RalphWystup/Kennlinienschreiber-fuer-Transistoren-mit-ESP32-und-BJT-Modell/bilder/bjt_dashboard.png

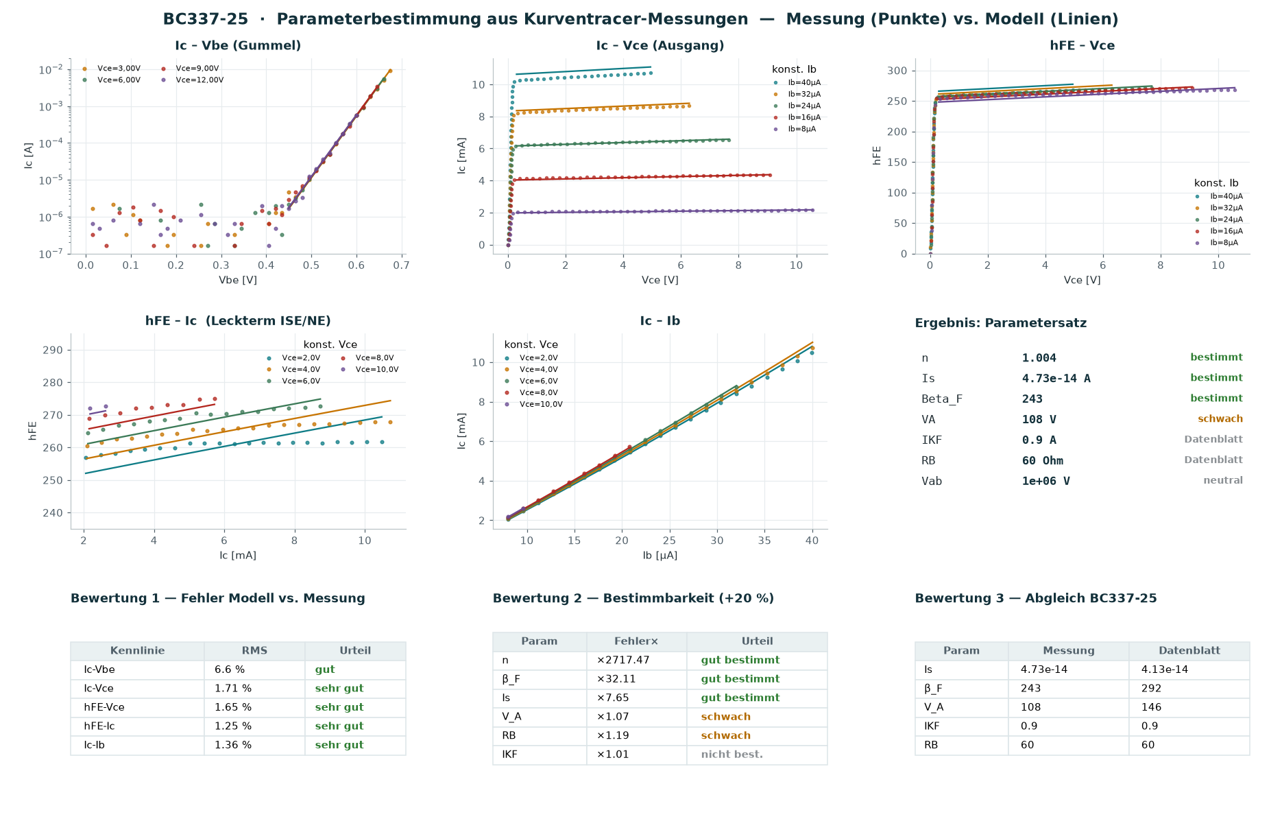
bilder/bjt_dashboard.png
