RalphWystup/Kennlinienschreiber-fuer-Transistoren-mit-ESP32-und-BJT-Modell/bilder/trendows_q3_blatt.png

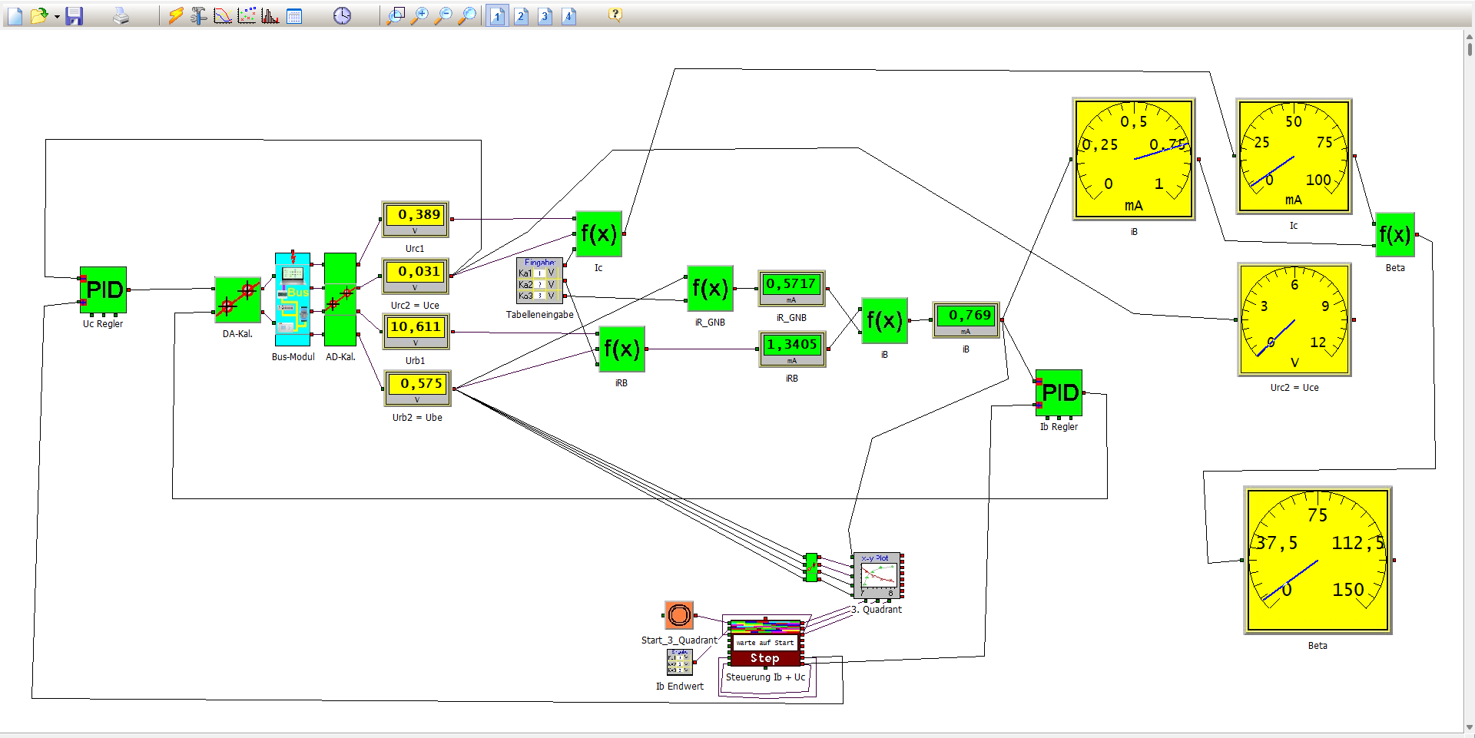
bilder/trendows_q3_blatt.png
