RalphWystup/Kennlinienschreiber-fuer-Transistoren-mit-ESP32-und-BJT-Modell/firmware/ad_da.h

// ---------------- ad_da ----------------------------------------

#ifndef __AD_DA_H__
#define __AD_DA_H__
#include "config.h"

extern "C"{

void setup_ad_da();
void WorkAdDa();

} // extern "C"
#endif /* ifndef */
