RalphWystup/Kennlinienschreiber-fuer-Transistoren-mit-ESP32-und-BJT-Modell/(commit log)

2026-09-30 Kennlinienschreiber fuer Transistoren mit ESP32 und BJT-Modell
    Ein selbstgebauter Messplatz nimmt Kennlinienfelder auf: zwei Digital-Analog-
    Umsetzer speisen Basis- und Kollektorzweig, vier Analog-Digital-Umsetzer messen
    zurueck, eine Kaskade aus zwei Reglern haelt Basisstrom und Kollektor-Emitter-
    Spannung. Manuskript mit Herleitung der Geraetekonstanten, Anleitung, Seite mit
    dem Messplatz als Simulation.
2026-09-30 Angaben fuer Zenodo
    Titel, Beschreibung, Schlagwoerter, Lizenz und Verweise, damit beim Archivieren
    nichts von Hand eingetippt werden muss.
2026-09-30 Kopfangaben fuer Suchmaschinen
    Kurzbeschreibung, kanonische Adresse, Vorschauangaben fuer geteilte Links und
    Strukturdaten nach schema.org — in der Seite und in der Weiterleitung. Die
    Angaben stammen aus derselben Quelle wie Startseite und Sitemap.
2026-09-30 Zitierangabe
    CITATION.cff: GitHub zeigt damit den Knopf "Cite this repository" mit fertigem
    Zitat, und Literaturverwaltungen koennen die Angabe auslesen. Ohne DOI und ohne
    Dritte.
